sfrwmaker/Inductance_meter/STM32/Drivers/hd44780/README

The lcd 1602 library for STM32. https://stm32withoutfear.blogspot.com/2016/10/stm32-lcd-wh16024-hd44780.html
