sfrwmaker/Inductance_meter/Arduino/l_meter.png

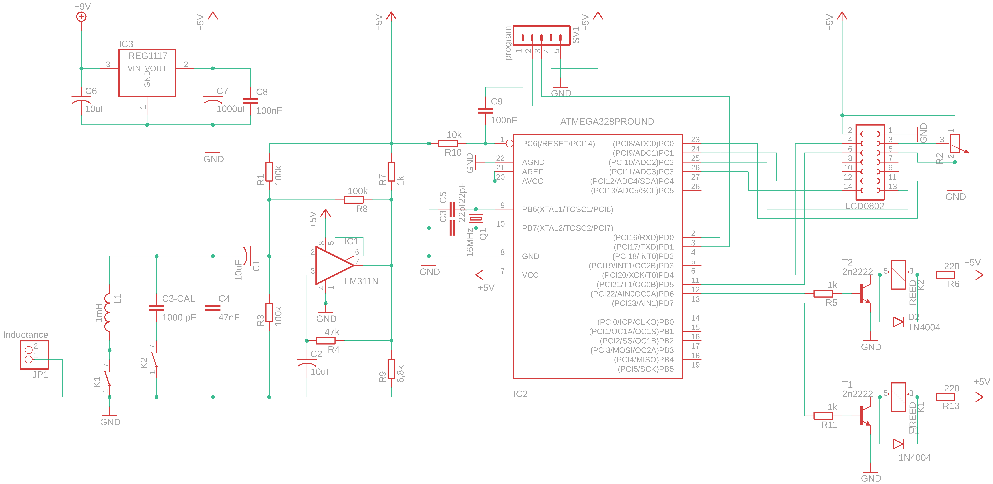
Arduino/l_meter.png
