sfrwmaker/Inductance_meter/STM32/lc_meter.png

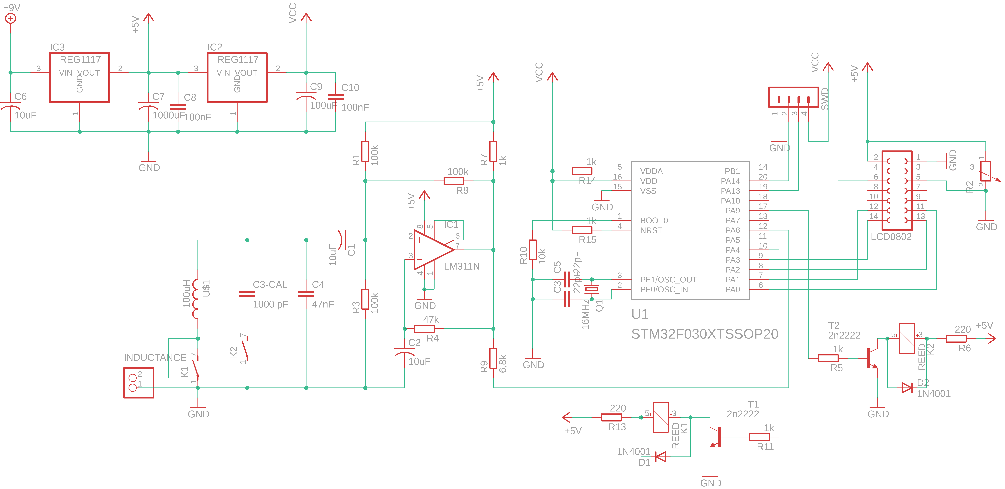
STM32/lc_meter.png
