sfrwmaker/Inductance_meter/Arduino/l_meter.sch

## EAGLE design Arduino/l_meter.sch (2019-03-15)

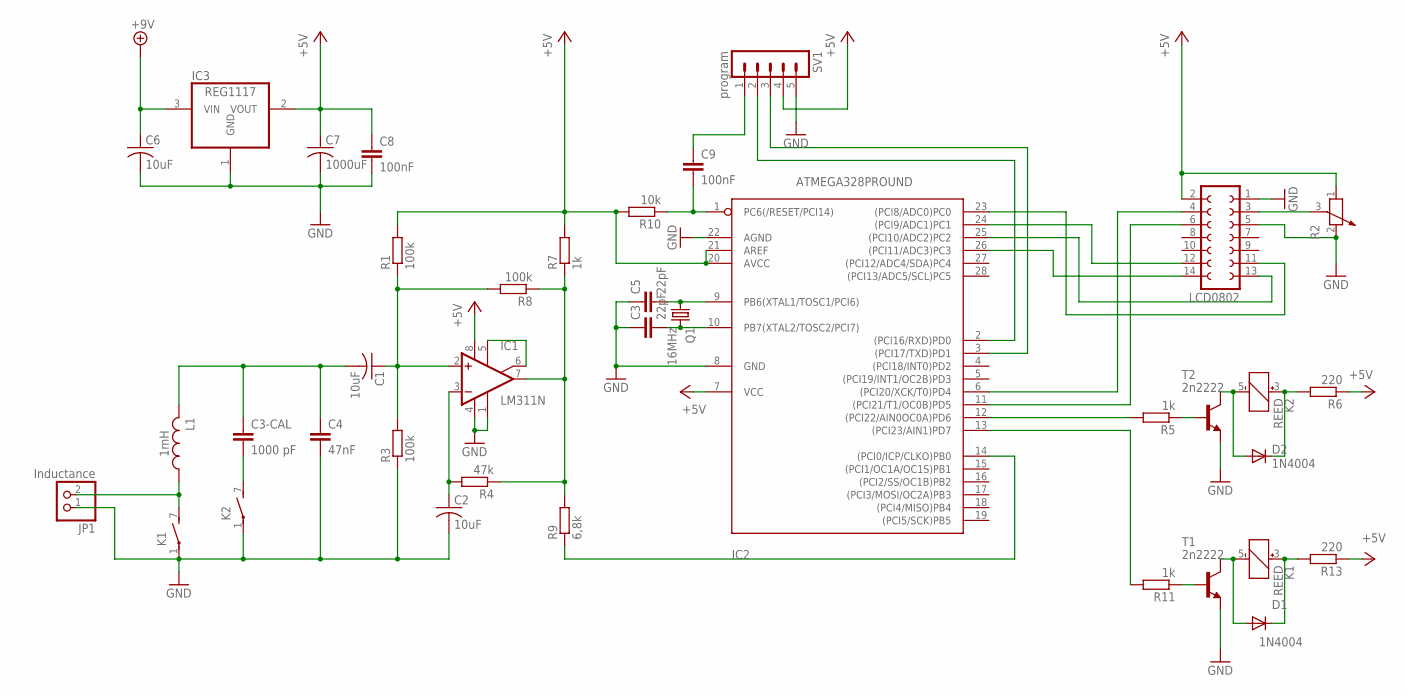
[picture p3: schematic l_meter.sch]

Parts:
C1, C2, C6: 10uF; C025-024X044
C3, C5: 22pF; C2.5-3
C3-CAL: 1000 pF; C2.5-3
C4: 47nF; C2.5-3
C7: 1000uF; C025-024X044
C8, C9: 100nF; C2.5-3
D1, D2: 1N4004; DO41-10
IC1: LM311N; DIL08
IC2: ATMEGA328PROUND; DIL28-3-ROUND
IC3: REG1117; SOT223
JP1: Inductance; 1X02
K1, K2: REED
L1: 1mH; RESC0805_N
LCD0802: FE07-2
Q1: 16MHz; HC18U-V
R1, R3, R8: 100k; 0204/7
R2: POTENTIOMETER_PT_SPIN; PT-SPIN
R4: 47k; 0204/7
R5, R7, R11: 1k; 0204/7
R6, R13: 220; 0204/7
R9: 6,8k; 0204/7
R10: 10k; 0204/7
SV1: program; MA05-1
T1, T2: 2n2222; TO92-EBC

Connections:
+5V: C7.1, C8.1, IC1.8 (V+), IC2.7 (VCC), IC2.20 (AVCC), IC2.21 (AREF), IC3.2 (VOUT), LCD0802.2, R1.2, R2.1, R6.1, R7.2, R10.2, R13.1, SV1.4
+9V: C6.1, IC3.3 (VIN)
GND: C2.2, C3.1, C4.2, C5.1, C6.2, C7.2, C8.2, IC1.1 (GND), IC1.4 (V-), IC2.8 (GND), IC2.22 (AGND), IC3.1 (GND), JP1.1, K1.1, K2.1, LCD0802.1, LCD0802.5, R2.2, R3.1, SV1.5, T1.E, T2.E
unnamed: C1.1, IC1.2 (+IN), R1.1, R3.2, R8.2
unnamed: C2.1, IC1.3 (-IN), R4.2
unnamed: C1.2, C3-CAL.1, C4.1, L1.2
unnamed: JP1.2, K1.7 (S), L1.1
unnamed: C9.2, IC2.1 (PC6(/RESET/PCI14)), R10.1
unnamed: IC1.5 (ON), IC1.6 (ON/STR)
unnamed: C5.2, IC2.9 (PB6(XTAL1/TOSC1/PCI6)), Q1.1
unnamed: IC1.7 (OUT), R4.1, R7.1, R8.1, R9.2
unnamed: C3.2, IC2.10 (PB7(XTAL2/TOSC2/PCI7)), Q1.2
unnamed: C9.1, SV1.1
unnamed: IC2.3 ((PCI17/TXD)PD1), SV1.3
unnamed: IC2.2 ((PCI16/RXD)PD0), SV1.2
unnamed: D1.A, K1.5 (-), T1.C
unnamed: R11.1, T1.B
unnamed: D1.C, K1.3 (+), R13.2
unnamed: IC2.23 ((PCI8/ADC0)PC0), LCD0802.11
unnamed: IC2.14 ((PCI0/ICP/CLKO)PB0), R9.1
unnamed: IC2.25 ((PCI10/ADC2)PC2), LCD0802.13
unnamed: IC2.24 ((PCI9/ADC1)PC1), LCD0802.12
unnamed: IC2.26 ((PCI11/ADC3)PC3), LCD0802.14
unnamed: LCD0802.3, R2.3
unnamed: C3-CAL.2, K2.7 (S)
unnamed: IC2.6 ((PCI20/XCK/T0)PD4), LCD0802.4
unnamed: IC2.12 ((PCI22/AIN0OC0A)PD6), R5.2
unnamed: IC2.13 ((PCI23/AIN1)PD7), R11.2
unnamed: IC2.11 ((PCI21/T1/OC0B)PD5), LCD0802.6
unnamed: R5.1, T2.B
unnamed: D2.A, K2.5 (-), T2.C
unnamed: D2.C, K2.3 (+), R6.2
