sfrwmaker/Inductance_meter/STM32/lc_meter.sch

## EAGLE design STM32/lc_meter.sch (2020-01-14)

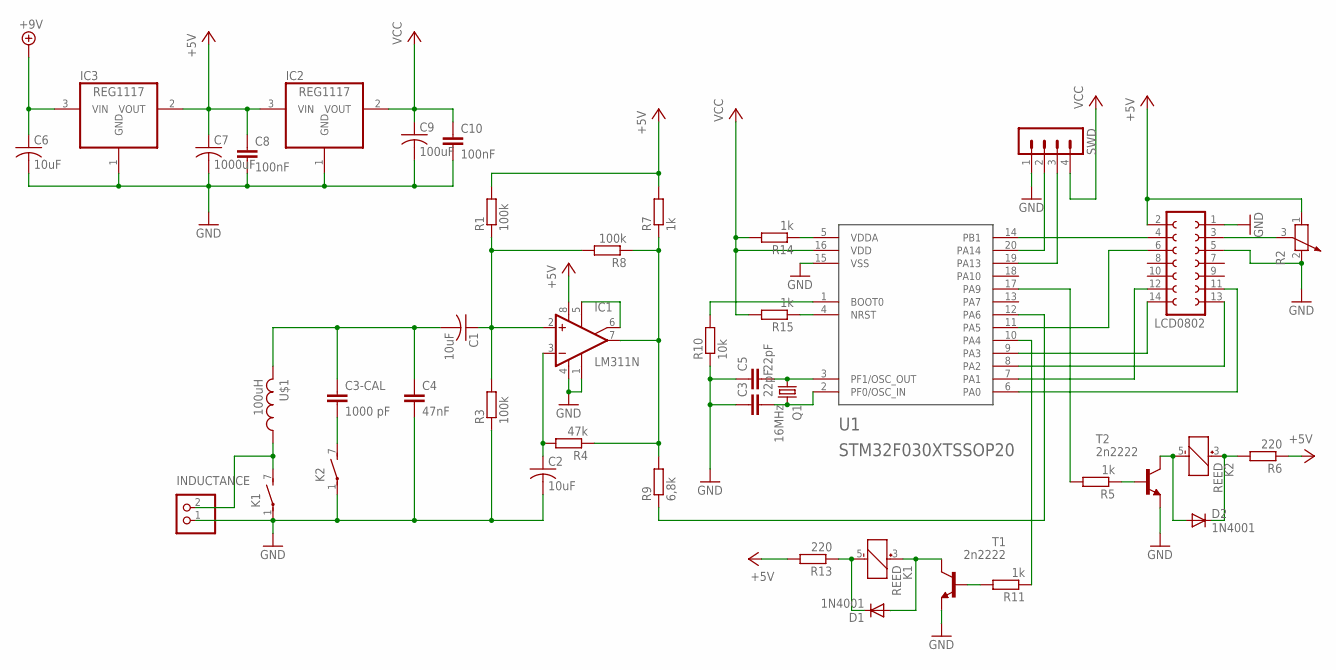
[picture p4: schematic lc_meter.sch]

Parts:
C1, C2, C6: 10uF; C025-024X044
C3, C5: 22pF; C2.5-3
C3-CAL: 1000 pF; C2.5-3
C4: 47nF; C2.5-3
C7: 1000uF; C025-024X044
C8, C10: 100nF; C2.5-3
C9: 100uF; C025-024X044
D1, D2: 1N4001; DO41-10
IC1: LM311N; DIL08
IC2, IC3: REG1117; SOT223
INDUCTANCE: PINHD-1X2; 1X02
K1, K2: REED
LCD0802: FE07-2
Q1: 16MHz; HC18U-V
R1, R3, R8: 100k; 0204/7
R2: POTENTIOMETER_PT_SPIN; PT-SPIN
R4: 47k; 0204/7
R5, R7, R11, R14, R15: 1k; 0204/7
R6, R13: 220; 0204/7
R9: 6,8k; 0204/7
R10: 10k; 0204/7
SWD: MA04-1
T1, T2: 2n2222; TO92-EBC
U1: STM32F030XTSSOP20; TSSOP-20
U$1: 100uH; RESC0805_N

Connections:
+5V: C7.1, C8.1, IC1.8 (V+), IC2.3 (VIN), IC3.2 (VOUT), LCD0802.2, R1.2, R2.1, R6.1, R7.2, R13.2
+9V: C6.1, IC3.3 (VIN)
GND: C2.2, C3.1, C4.2, C5.1, C6.2, C7.2, C8.2, C9.2, C10.2, IC1.1 (GND), IC1.4 (V-), IC2.1 (GND), IC3.1 (GND), INDUCTANCE.1, K1.1, K2.1, LCD0802.1, LCD0802.5, R2.2, R3.1, R10.1, SWD.1, T1.E, T2.E, U1.15 (VSS)
unnamed: C1.1, IC1.2 (+IN), R1.1, R3.2, R8.2
unnamed: C2.1, IC1.3 (-IN), R4.2
unnamed: C1.2, C3-CAL.1, C4.1, U$1.2
unnamed: R11.1, U1.10 (PA4)
unnamed: IC1.5 (ON), IC1.6 (ON/STR)
unnamed: C5.2, Q1.1, U1.3 (PF1/OSC_OUT)
unnamed: IC1.7 (OUT), R4.1, R7.1, R8.1, R9.2
unnamed: C3.2, Q1.2, U1.2 (PF0/OSC_IN)
unnamed: LCD0802.11, U1.6 (PA0)
unnamed: LCD0802.12, U1.7 (PA1)
unnamed: LCD0802.13, U1.8 (PA2)
unnamed: R11.2, T1.B
unnamed: D1.A, K1.3 (+), T1.C
unnamed: D1.C, K1.5 (-), R13.1
unnamed: R9.1, U1.12 (PA6)
unnamed: R15.1, U1.4 (NRST)
unnamed: R14.1, U1.5 (VDDA)
unnamed: R10.2, U1.1 (BOOT0)
unnamed: LCD0802.14, U1.9 (PA3)
unnamed: LCD0802.3, R2.3
unnamed: C3-CAL.2, K2.7 (S)
unnamed: LCD0802.4, U1.14 (PB1)
unnamed: LCD0802.6, U1.11 (PA5)
unnamed: R5.2, U1.17 (PA9)
unnamed: INDUCTANCE.2, K1.7 (S), U$1.1
unnamed: SWD.2, U1.20 (PA14)
unnamed: SWD.3, U1.19 (PA13)
unnamed: R5.1, T2.B
unnamed: D2.A, K2.5 (-), T2.C
unnamed: D2.C, K2.3 (+), R6.2
VCC: C9.1, C10.1, IC2.2 (VOUT), R14.2, R15.2, SWD.4, U1.16 (VDD)
