sfrwmaker/Inductance_meter/STM32/Drivers/hd44780/hd44780_cfg.h

//------------------------------------------------------
/* File:       Library for HD44780 compatible displays  */
/* Version:	   v2.01  						 			*/
/* Author:     GrAnd/www.MakeSystem.net		 			*/
/* Tested on:  AVR, STM32F10X			 	 		 	*/
/* License:	   GNU LGPLv2.1		 		 	 			*/
//------------------------------------------------------
/* Copyright (C)2014 GrAnd. All right reserved 			*/
//------------------------------------------------------

/*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
Contact information :
						mail@makesystem.net
						http://makesystem.net/?page_id=2
*/

#ifndef LCD_CFG_H
#define LCD_CFG_H

/* Include here the header file of your microcontroller */
//#include "stm32f10x.h"
//#include "stm32f10x_gpio.h"
//#include "stm32f10x_rcc.h"
//#include <avr/io.h>
#include "main.h"

//-------------------------------
/* SET LCD<->MCU CONNECTIONS */
//-------------------------------
#define MASK2PIN(mask) ((mask&GPIO_PIN_0)?0:(mask&GPIO_PIN_1)?1:(mask&GPIO_PIN_2)?2:(mask&GPIO_PIN_3)?3: \
						(mask&GPIO_PIN_4)?4:(mask&GPIO_PIN_5)?5:(mask&GPIO_PIN_6)?6:(mask&GPIO_PIN_7)?7: \
						(mask&GPIO_PIN_8)?8:(mask&GPIO_PIN_9)?9:(mask&GPIO_PIN_10)?10:(mask&GPIO_PIN_11)?11: \
						(mask&GPIO_PIN_12)?12:(mask&GPIO_PIN_13)?13:(mask&GPIO_PIN_14)?14:(mask&GPIO_PIN_15)?15:0)

#define RS_PIN_NUMBER (MASK2PIN(LCD_RS_Pin))
#define E_PIN_NUMBER (MASK2PIN(LCD_E_Pin))
#define RW_PIN_NUMBER (MASK2PIN(LCD_RW_Pin))
#define D7_PIN_NUMBER (MASK2PIN(LCD_D7_Pin))
#define D6_PIN_NUMBER (MASK2PIN(LCD_D6_Pin))
#define D5_PIN_NUMBER (MASK2PIN(LCD_D5_Pin))
#define D4_PIN_NUMBER (MASK2PIN(LCD_D4_Pin))

/* E - Starts data read/write. */
#define LCD_E_OUT					LCD_E_GPIO_Port->ODR	/* Output register */
#define LCD_E 	 					E_PIN_NUMBER			/* Pin number */

/* RS - Selects registers.
 * 0:	Instruction register (for write)
 * 0:	Busy flag + address counter (for read)
 * 1:	Data register (for write and read) */
#define LCD_RS_OUT					LCD_RS_GPIO_Port->ODR	/* Output register */
#define LCD_RS 						RS_PIN_NUMBER			/* Pin number */

/* R/W - Selects read or write.
 * 0:	Write
 * 1:	Read */
#define LCD_RW_OUT					LCD_RW_GPIO_Port->ODR	/* Output register */
#define LCD_RW						RW_PIN_NUMBER			/* Pin number */

/* DB4 to DB7 - Four high order bidirectional tristate data bus pins.
 * Used for data transfer and receive between the MPU and the HD44780U.
 * DB7 can be used as a busy flag. */
#define LCD_D7_OUT					LCD_D7_GPIO_Port->ODR	/* Output register */
#define LCD_D7_IN					LCD_D7_GPIO_Port->IDR	/* Input register */
#define LCD_D7 	 					D7_PIN_NUMBER			/* Pin number */

#define LCD_D6_OUT					LCD_D6_GPIO_Port->ODR	/* Output register */
#define LCD_D6						D6_PIN_NUMBER			/* Pin number */

#define LCD_D5_OUT					LCD_D5_GPIO_Port->ODR	/* Output register */
#define LCD_D5						D5_PIN_NUMBER			/* Pin number */

#define LCD_D4_OUT					LCD_D4_GPIO_Port->ODR	/* Output register */
#define LCD_D4						D4_PIN_NUMBER			/* Pin number */

//-------------------------------
// DEFAULT CONFIGURATIONS
//-------------------------------
#define DEFAULT_DISPLAY_CONFIG		DISPLAY_CONFIG_4bit_2L_5x8
#define DEFAULT_ENTRY_MODE			ENTRY_MODE_INC_NO_SHIFT
#define DEFAULT_VIEW_MODE			VIEW_MODE_DispOn_BlkOff_CrsOff
#define USE_BUSY_FLAG				0u	/* 1 (true) or 0 (false) */

//-------------------------------
// SET MCU TIMINGS
//-------------------------------
#define MCU_FREQ_VALUE				SystemCoreClock/1000000	/* MHz. Minimal value = 1 MHz */
#define BUSY_CYCLE_TIME				5u						/* x 10us. See datasheet for minimal value. */
#define CLRSCR_CYCLE_TIME			200u					/* x 10us. See datasheet for minimal value. */
#define RETHOME_CYCLE_TIME			200u					/* x 10us. See datasheet for minimal value. */
#define INIT_CYCLE_TIME				400u
//-------------------------------
// CONFIGURE LCD WITH 4 LINES
//-------------------------------
#define START_ADDRESS_3rd_LINE		0x10u
#define START_ADDRESS_4th_LINE		0x50u

//-------------------------------
// SET FORMATTED OUTPUT OPTIONS
//-------------------------------
#define USE_FORMATTED_OUTPUT	 	1u	/* 1 (true) or 0 (false) */
#define TAB_SPACE					4u	/* 1 .. 255 */

//-------------------------------
// PROGRESS BAR OPTIONS
//-------------------------------
#define USE_PROGRESS_BAR			0u				/* 1 (true) or 0 (false) */
#define USE_REGRESS_BAR				1u				/* 1 (true) or 0 (false) */
#define PROGRESS_BAR_LINE			LCD_2nd_LINE	/* Select lcd line: 1, 2, 3, 4, ... */
#define PROGRESS_BAR_HEIGHT			5u  			/* in pixel: 1(min), 2, 3, 4, 5, 6, 7, 8(max) */
#define PROGRESS_BAR_WIDTH			10u 			/* Number of chars in lcd line:  1, 2, .. , 8, 16, 20 */

//-------------------------------
// LCDlib CALLBACKS
//-------------------------------
#if (USE_BUSY_FLAG)

#define Set_D7_as_Input()	\
	GPIOA->CRL &= 0xFFF0FFFFu;	\
	GPIOA->CRL |= 0x00040000u;

#define Set_D7_as_Outut()	\
	GPIOA->CRL &= 0xFFF0FFFFu;	\
	GPIOA->CRL |= 0x00030000u;

#endif /* USE_BUSY_FLAG */

void lcdGpioInit(void);
#define setAllPinsAsOutputs()	lcdGpioInit()

#endif /* LCD_CFG_H */

//-------------------------------
/* THE END */
//-------------------------------
