sfrwmaker/Inductance_meter/STM32/src/main.c

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

/* Includes ------------------------------------------------------------------*/
#include "main.h"

/* USER CODE BEGIN Includes */
#include "hd44780.h"
#include <math.h>
#include <stdlib.h>

/* USER CODE END Includes */

TIM_HandleTypeDef htim3;

/* USER CODE BEGIN PV */
const double	cal_cap_uF	= 0.001066;									// The calibration capacitance (micro farads)
const double	four_pi_sq	= 39.4784176043574344753379639995;			// 4 * PI^2
const uint32_t 	OPEN_TICKS  = 330000;            						// The sum of ticks in the pulse[] when the circuit is open

// The buffer for pulse data
#define			BUFF_SZ		8
volatile static	uint16_t	pulse[BUFF_SZ];
volatile static uint8_t		pulse_index = 0;
volatile static	uint8_t		pulse_ready = 0;							// The whole buffer has been filled
static double				ticks_LC	= 0.0;
static double				ticks_LCC	= 0.0;

/* USER CODE END PV */

void SystemClock_Config(void);
static void MX_GPIO_Init(void);
static void MX_TIM3_Init(void);
/* USER CODE BEGIN PFP */

/* USER CODE END PFP */

/* USER CODE BEGIN 0 */


// Capture the signal from the timer. 48 ticks per microseconds
void HAL_TIM_IC_CaptureCallback(TIM_HandleTypeDef *htim) {
	if (htim == &htim3) {
		if (htim->Channel == HAL_TIM_ACTIVE_CHANNEL_1) {
			pulse[pulse_index] = HAL_TIM_ReadCapturedValue(htim, TIM_CHANNEL_1);
			if (++pulse_index >= 8) {
				pulse_index = 0;
				pulse_ready = 1;
			}
		}
	}
}

void HAL_TIM_PeriodElapsedCallback(TIM_HandleTypeDef *htim) { }

// Absolute difference of two positive values
uint16_t abs_diff(uint16_t a, uint16_t b) {
    if (a >= b) {
        return a - b;
    } else {
        return b - a;
    }
}

// Oscillation period, ticks
uint32_t oscTicksSumm(uint8_t reset) {
	if (reset) {
		pulse_ready = pulse_index = 0;									// Clear up the buffer
		while (!pulse_ready) ;											// Wait till the whole buffer has been filled up
	}
	uint32_t summ = 0;
	for (uint8_t i = 0; i < 10; ++i) {
		summ	= 0;
		uint16_t min_v	= 65535;
		uint16_t max_v	= 0;
		for (uint8_t i = 0; i < BUFF_SZ; ++i) {
			uint16_t p = pulse[i];
			if (p > max_v) max_v = p;
			if (p < min_v) min_v = p;
			summ += p;
		}
		if (abs_diff(min_v, max_v) < 100) break;
		lcdClrScr();
		pulse_ready = pulse_index = 0;									// Clear up the buffer
		HAL_Delay(1000);												// Wait till the whole buffer has been filled up
	}
	return summ;
}

// The square of the period, microseconds^2. Argument - period in ticks
double periodSquare(double P) {
    double ticks_per_mks = (double)HAL_RCC_GetHCLKFreq() / 1000000.0;  	// The number of timer ticks per one mirco second
    P /= ticks_per_mks;                         						// Convert ticks to micro seconds
    P *= P;
    return P;
}

// Frequently used coefficient:  (P2^2 - P1^2) / P1^2
double pCoeff(double P1, double P2) {
    P1 *= P1;
    P2 *= P2;
    double r  = (P2 - P1) / P1;
    if (r < 0) r = 0;
    return r;
}

void calibrate(void) {
    while (1) {
    	HAL_GPIO_WritePin(SHORT_GPIO_Port, SHORT_Pin, GPIO_PIN_SET);	// Short the external socket
    	HAL_Delay(100);
        ticks_LC = (double)oscTicksSumm(1) / (double)BUFF_SZ;			// Period of the internal oscillation circuit, ticks
        HAL_GPIO_WritePin(CALIB_GPIO_Port, CALIB_Pin, GPIO_PIN_SET);	// Connect the calibration capacitor
        HAL_Delay(100);
        ticks_LCC = (double)oscTicksSumm(1) / (double)BUFF_SZ;				// Period of the internal oscillation circuit + calibration capacitor, ticks
        HAL_GPIO_WritePin(CALIB_GPIO_Port, CALIB_Pin, GPIO_PIN_RESET);	// Disconnect the calibration capacitor
        HAL_GPIO_WritePin(SHORT_GPIO_Port, SHORT_Pin, GPIO_PIN_RESET);	// Open the external socket
        HAL_Delay(200);
        if (ticks_LCC > ticks_LC) break;
        lcdClrScr();
        HAL_Delay(2000);
    }
    while (!pulse_ready) ;												// Wait till the whole buffer has been filled up
    //volatile double int_cap	= cal_cap_uF / pCoeff(ticks_LC, ticks_LCC);
}

void printValue(double value) {
    char buff[3]	= "xH";
    buff[0] = 'u';
    if (value > 1000.0) {
        value /= 1000;
        buff[0] = 'm';
    }

    uint8_t value_size = 3;
    if (value >= 100.0)
    	value_size = 5;
    else if (value >= 10.0)
    	value_size = 4;

    lcdGoto(LCD_1st_LINE, 0);
    lcdPuts("Induct.");
    lcdGoto(LCD_2nd_LINE, 0);
    for (uint8_t i = 0; i < 6-value_size; ++i)
    	lcdPutc(' ');
    lcdFtos(value, 1);
    lcdPuts(buff);
}

void checkInductance(void) {
    static uint16_t ticks_prev	 = 0;									// previous Period of the oscillation, including external inductance or capacitance, ticks
    static uint32_t calibrate_ms = 0;

    uint32_t ticks_new	= oscTicksSumm(0);								// Period of the internal oscillation circuit plus external thing, ticks
    if (ticks_new >= OPEN_TICKS) {
    	lcdClrScr();
        lcdPuts(" NO");
        lcdGoto(LCD_2nd_LINE, 0);
        lcdPuts("value");
    	HAL_Delay(1000);
        return;
    }

    double ticks 	= (double)ticks_new / (double)BUFF_SZ;
    double pi_coeff	= 1 / (four_pi_sq * cal_cap_uF);					// 1 / (4 * PI^2 * Cc)
    double int_ind	= (periodSquare(ticks_LCC) - periodSquare(ticks_LC)) * pi_coeff;
    double ext_ind	= int_ind * pCoeff(ticks_LC, ticks);

    printValue(ext_ind);
    if (HAL_GetTick() >= calibrate_ms || (ticks_prev && abs_diff(ticks_new, ticks_prev) > (BUFF_SZ >> 1))) {
        calibrate_ms = HAL_GetTick() + 10000;							// Do calibration every 10 seconds
        calibrate();
    }
    ticks_prev = ticks_new;
}

/* USER CODE END 0 */

/**
  * @brief  The application entry point.
  * @retval int
  */
int main(void)
{
  /* MCU Configuration--------------------------------------------------------*/

  /* Reset of all peripherals, Initializes the Flash interface and the Systick. */
  HAL_Init();

  /* Configure the system clock */
  SystemClock_Config();

  /* Initialize all configured peripherals */
  MX_GPIO_Init();
  MX_TIM3_Init();
  /* USER CODE BEGIN 2 */
  HAL_Delay(500);
  lcdInit();

  HAL_TIM_IC_Start_IT(&htim3, TIM_CHANNEL_1);
  /* USER CODE END 2 */

  /* Infinite loop */
  /* USER CODE BEGIN WHILE */

  lcdClrScr();
  calibrate();

  while (1)
  {
	  checkInductance();
	  HAL_Delay(1000);
    /* USER CODE END WHILE */

    /* USER CODE BEGIN 3 */

  }
  /* USER CODE END 3 */
}

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
