sfrwmaker/Inductance_meter/STM32/F0-lc_meter.ioc

Mcu.UserName=STM32F030F4Px
PA0.GPIO_Label=LCD_D4
PA0.Signal=GPIO_Output
PA1.GPIO_Label=LCD_D5
PA1.Signal=GPIO_Output
PA13.Signal=SYS_SWDIO
PA14.Signal=SYS_SWCLK
PA2.GPIO_Label=LCD_D6
PA2.Signal=GPIO_Output
PA3.GPIO_Label=LCD_D7
PA3.Signal=GPIO_Output
PA4.GPIO_Label=SHORT
PA4.Signal=GPIO_Output
PA5.GPIO_Label=LCD_E
PA5.Signal=GPIO_Output
PA6.GPIO_Label=FREQ
PA6.Signal=S_TIM3_CH1
PA9.GPIO_Label=CALIB
PA9.Signal=GPIO_Output
PB1.GPIO_Label=LCD_RS
PB1.Signal=GPIO_Output
PF0-OSC_IN.Signal=RCC_OSC_IN
PF1-OSC_OUT.Signal=RCC_OSC_OUT
