sfrwmaker/Inductance_meter/(notices)

Notices in the files:
STM32/src/main.c:
COPYRIGHT(c) 2019 STMicroelectronics
(C) COPYRIGHT STMicroelectronics *****END OF FILE
